christophschwaerzler/GPSCO/Allan deviation/Allan_Plot.jpg

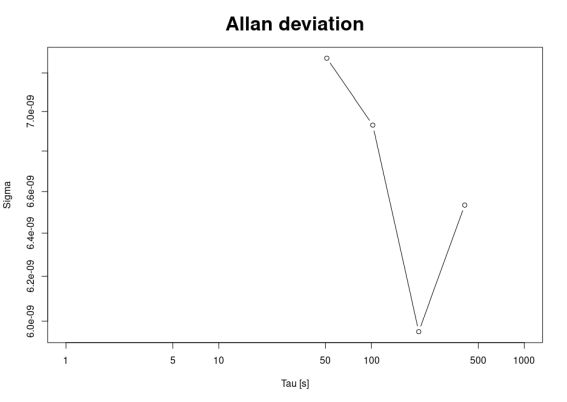
Allan deviation/Allan_Plot.jpg
