christophschwaerzler/GPSCO/Figures/OCXO_schematics.jpg

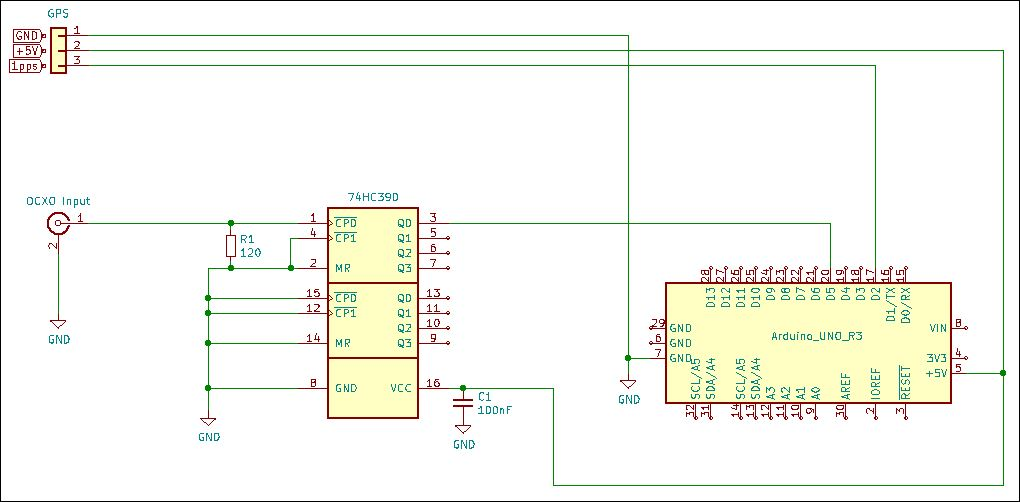
Figures/OCXO_schematics.jpg
