christophschwaerzler/GPSCO/Figures/OCXO_schematics_full.jpg

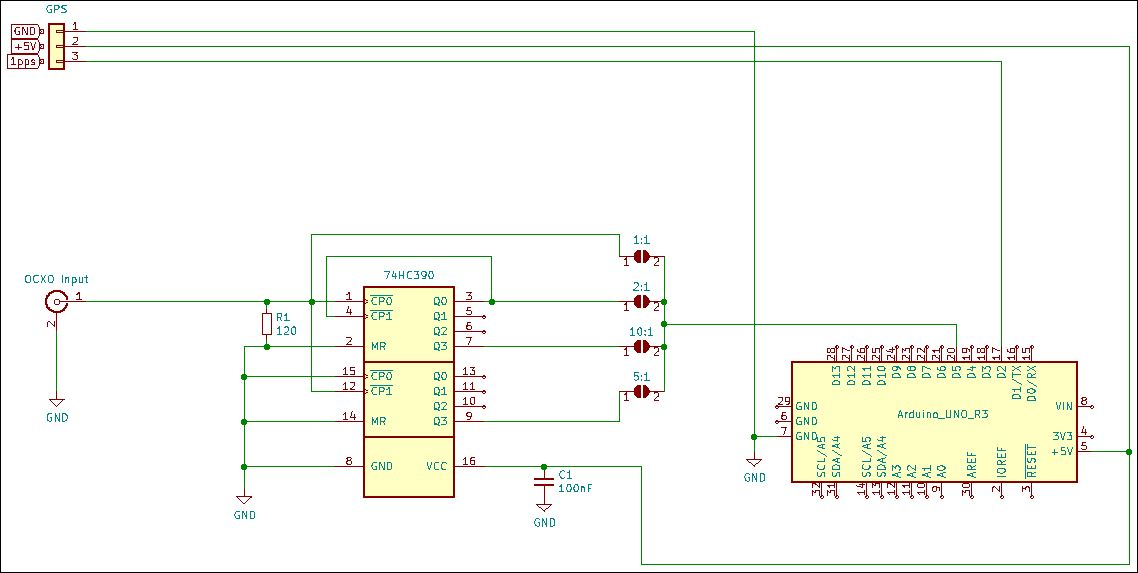
Figures/OCXO_schematics_full.jpg
