christophschwaerzler/GPSCO/Gate delay/Adjusted frequency.jpg

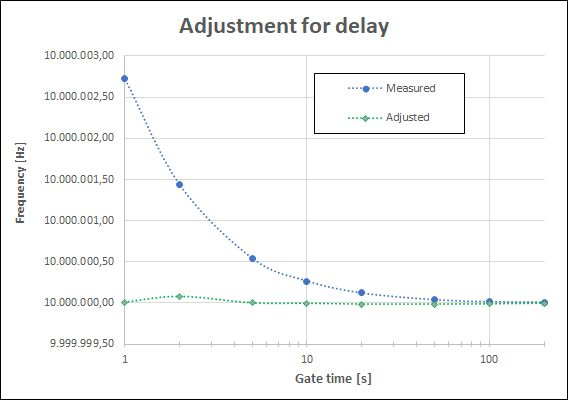
Gate delay/Adjusted frequency.jpg
