christophschwaerzler/GPSCO/Gate delay/Adjustment formula.JPG

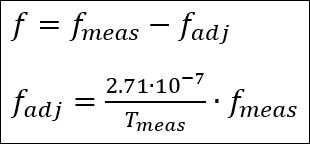
Gate delay/Adjustment formula.JPG
