christophschwaerzler/GPSCO/Gate delay/Code.jpg

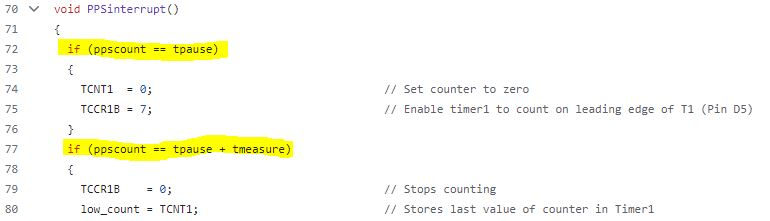
Gate delay/Code.jpg
