christophschwaerzler/GPSCO/Allan deviation/Allan_results.xlsx

Tau | Sigma
101 | 2.327373374e-09
202 | 2.032686207e-09
404 | 2.259315536e-09
808 | 2.32089956e-09
