christophschwaerzler/GPSCO/Allan deviation/Allan_results_20s.xlsx

Tau | Sigma
21 | 2.20071288e-08
42 | 1.924646422e-08
84 | 1.545431207e-08
168 | 1.432957259e-08
336 | 1.058067426e-08
672 | 9.619577033e-09
1344
