christophschwaerzler/GPSCO/Allan deviation/Allan_results_2s.xlsx

Tau | Sigma
3 | 6.874791944e-08
6 | 6.860520162e-08
12 | 6.873010389e-08
24 | 6.937140436e-08
48 | 7.00783465e-08
96 | 7.086246629e-08
