christophschwaerzler/GPSCO/Allan deviation/Allan_results_50s.xlsx

Tau | Sigma
51 | 7.278583468e-09
102 | 6.930678256e-09
204 | 5.953795133e-09
408 | 6.533274306e-09
816 | Inf
