christophschwaerzler/GPSCO/Allan deviation/Allan_results_5s.xlsx

Tau | Sigma
6 | 3.056065151e-08
12 | 3.154022293e-08
24 | 2.926945348e-08
48 | 3.151291325e-08
96 | 3.019434457e-08
192 | 3.004367259e-08
