christophschwaerzler/GPSCO/(commit log)

2023-12-03 New report
    [Auswertung Messzeit.xlsx]
2023-12-04 GPSCO.ino: Delete 'Divider' Add Folder 'Figures' Correct Schematics_full (1:5 <-> 1:10) Update README.md
    [Auswertung Messzeit.xlsx]
2023-12-05 Move some files to folders
    [Auswertung Messzeit.xlsx]
2023-12-05 Remove unused library calls
    Unused libraries are no longer included and some minor changes to comments
    [GPSCO.ino]
2023-12-08 Sample Files
